is-so-cool/esp32-wireless-kvm/images/IMG_5471.jpeg

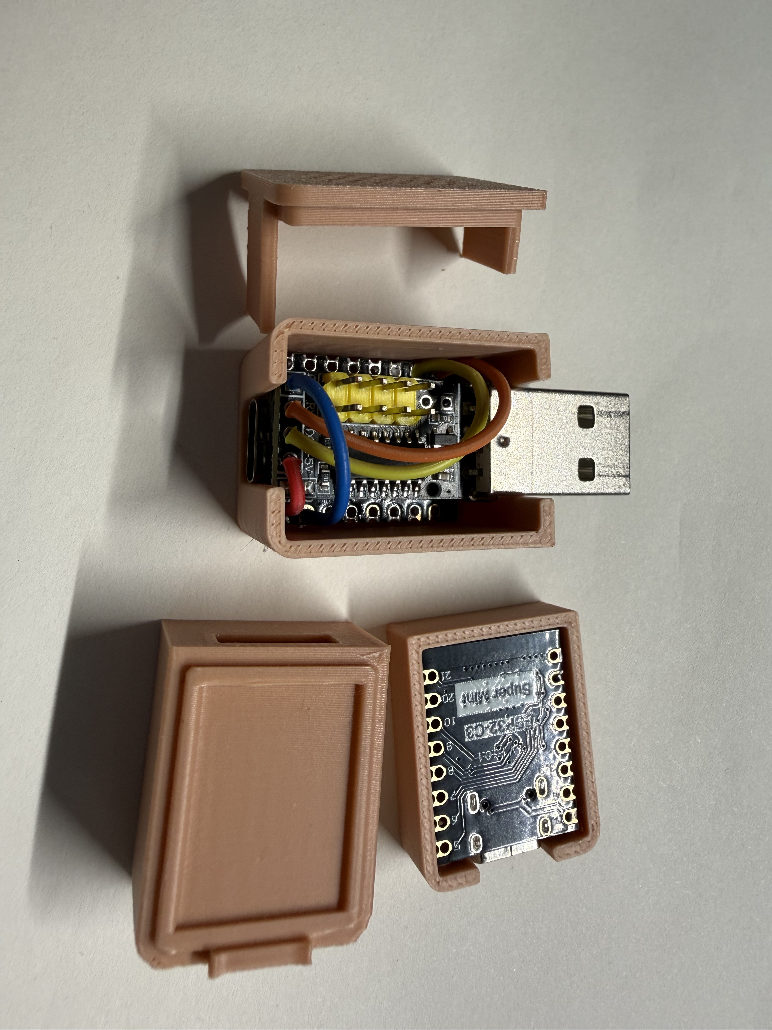
images/IMG_5471.jpeg
