is-so-cool/esp32-wireless-kvm/images/IMG_5470.jpeg

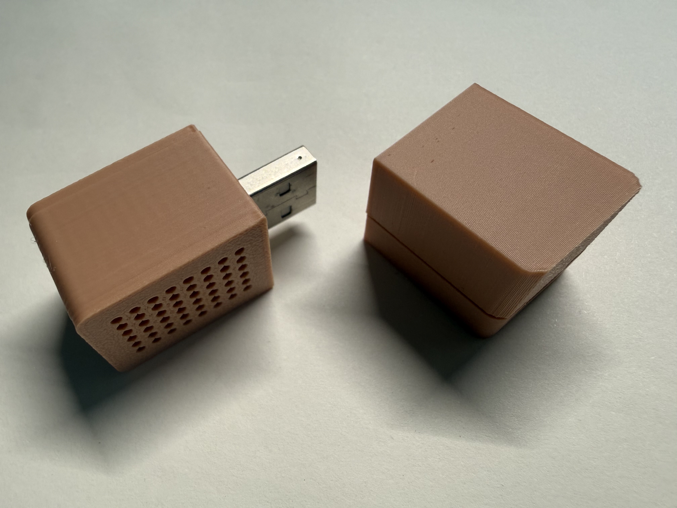
images/IMG_5470.jpeg
