is-so-cool/esp32-wireless-kvm/scad/main.3mf

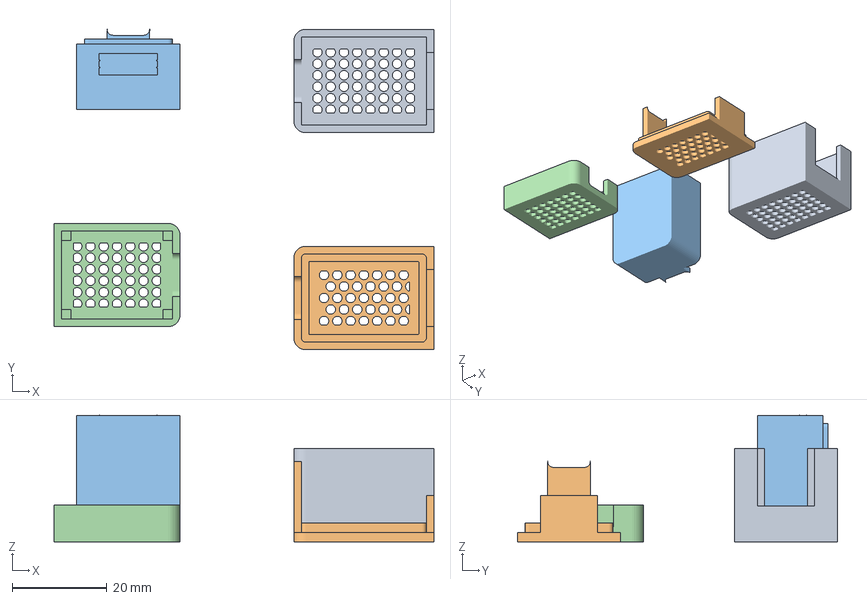
[picture p3: CAD file, 2026-10-02]
scad/main.3mf
80.2 x 67.6 x 26.7 mm
main.stl_3
main.stl_4
main.stl_2
main.stl_1
