is-so-cool/esp32-wireless-kvm/(list of files, cad)

Other CAD files:
scad/sender.scad
scad/main.stl
